Mohanad-Ramadan/sofle-v2-wireless-case/(list of files, drawings)

Other design files:
data/pcb_outline.json
