Mohanad-Ramadan/sofle-v2-wireless-case/(commit log)

2026-04-25 Add Sofle V2 wireless case design spec
    Comprehensive tray-mount case design for Sofle V2 wireless keyboard (nice!nano MCU, MX hot-swap, EC11 encoder, 0.91" OLED). Specifications cover:
    - PCB geometry (143.5 × 115.5 mm irregular outline from GERBER)
    - 5× M2 integrated standoffs (stepped, floor to plate)
    - Tray mounting with open top
    - MCU cover (17 mm tall, merges with +Y wall for USB-C access)
    - Cutouts for slide switch, reset button, USB-C, encoder, OLED
    - Build123d (Python CAD) implementation framework
    - Material & print notes (PLA/PETG, 0.2 mm layer height)
    Design verified against component placements (CPL) and heights (reference STL).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
2026-04-25 constants: dimensions + PCB→case transform with sanity tests
2026-04-25 fix: MOUNTING_HOLES → immutable tuple; type annotations; comment consistency
2026-04-25 data: vendored EdgeCuts gerber, PTH drill, CPL
    [CPL-SofleKeyboard.csv, SofleKeyboard-EdgeCuts.gbr, SofleKeyboard-PTH.drl]
2026-04-25 parse: GERBER edgecuts + Excellon drill → JSON cache
    [pcb_outline.json]
2026-04-25 fix: remove collinear polygon vertices; arc guard; cleanup
    - Add _remove_collinear() helper to strip collinear mid-points from
    polygon output (22 → 19 vertices); prevents OCCT failures on offset()
    - Add arc-segment guard raising ValueError if G02/G03 codes detected
    - Rename header → text in parse_pth_holes for clarity
    - Remove unused import sys
    - Fix hardcoded 4.1 echo string to use target_dia_mm variable
    [pcb_outline.json]
2026-04-25 parse: CPL CSV → components.json
2026-04-26 geometry: load PCB polygon + translate to case coords
2026-04-26 test: cached holes match constants
2026-04-26 standoff: stepped standoff with M2 self-tap bore
2026-04-26 tray: outer shell + PCB-shaped cavity + top chamfer
2026-04-26 fix: cavity overshoot epsilon 1.0→0.01; drop no-op Plane.XY.offset(0)
2026-04-26 cutouts: USB-C, slide-switch slot, reset pin, floor recess
2026-04-26 case: compose tray+standoffs+cover-cutouts; mirror for right half
2026-04-26 cli: build.py exports STL + STEP per side
2026-04-26 test: print envelope fits 250x210 bed
2026-04-27 feat: integrate OCP CAD Viewer with show() support and Pylance fixes
    - Add OCP CAD Viewer show() blocks to all geometry modules (case, tray, cutouts, mcu_cover, standoffs)
    - Add --show flag to build.py for optional viewer launch
    - Guard show() calls with __main__ checks to prevent circular import
    - Use absolute imports for VS Code REPL compatibility
    - Resolve all Pylance/pyright type errors across geometry modules
    - Add AGENT.md with development instructions
2026-05-01 feat: reshaped cutouts for better design experince + built phantom pcb model
2026-05-01 feat: switch plate + MX switch phantoms, Z-stack doc, plate thickness fix
    Switch plate phantom (plate_phantom.py):
    - Parse top_plate.kicad_pcb Edge.Cuts → plate_outline.json + plate_cutouts.json
    (30 cutouts: 29 MX 14×14mm + 1 encoder hole)
    - Plate phantom extruded PLATE_SEAT_Z→PLATE_TOP_Z with cutouts and mounting holes
    MX switch phantom (switch_phantom.py):
    - 29 MX switches: lower housing (13.8×13.8×3mm in gap) + upper housing
    (15.6×15.6×6.6mm above plate) + stem (Ø4.5×3.5mm)
    - Positions + rotations from data/components.json (top-layer SW*, excludes encoder SW25)
    - Gated by SHOW_SWITCH_PHANTOM (default False)
    Z-stack geometry corrections:
    - PLATE_SEAT_Z = 9.1 (PCB_TOP_Z + 3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
2026-05-03 feat: raise case rim to mid-upper-housing height + PNG export flag
    - Add --png flag to build.py for OCP viewer screenshot export
    - Raise MAIN_RIM_Z from 12.0 → 14.0 mm (midpoint of MX upper housing
    10.7 → 17.3 mm); USB_C_Z_RANGE and SLIDE_SWITCH_Z_RANGE auto-adjust
    - Update z-stack.md and AGENT.md to reflect new rim height
2026-05-22 feat(case): full case revamp — PCB-profile shell, MCU hill, smooth tray curves (#1)
    * feat: PCB-profile outer shell + minimalist 2.5mm walls
    Replace rectangular outer shell with PCB polygon offset outward by
    (WALL_THICKNESS + PCB_XY_CLEARANCE = 3.0mm) using Kind.ARC corners.
    Case silhouette now follows the PCB outline exactly — thumb cluster
    diagonal, OLED/encoder step notches, right-side step-down.
    - WALL_THICKNESS: 3.0 → 2.5mm; OUTER_WIDTH/DEPTH: 162×131 → 149.5×121.5mm
    - tray._outer_shell(): polygon offset replaces RectangleRounded
    - tray._fillet_top_edges(): fillet replaces chamfer (polygon ARC corner
    segments break OCC chamfer; fillet handles them robustly)
    - constants: ad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
2026-05-31 feat(case): implement mirroring for right case half (#2)
    * feat(case): implement mirroring for right case half geometry
    Enhance the `build_case_half` function to support mirroring of the case geometry when the `side` parameter is set to "right". This allows for the correct alignment of the MCU hill on the +X wall. Additionally, a new helper function `_mirror_part` is introduced to apply the same transformation to phantom parts, ensuring consistent alignment with the case geometry. Update the main execution block to utilize this new functionality for PCB and other phantoms.
    * fix(case): correct mirroring logic for case halves
    Update the `build_case_half` function to ensure that the "left"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
2026-07-03 chore(docs): fdm-printability-fixes into main
2026-07-05 feat(battery): support 405070 LiPo cell with MCU cover clearance
    Adds a 50x70x4mm battery pocket sized for larger-capacity 405070 cells
    and relieves the MCU cover +Y wall so the B+/B- pins clear the case.
2026-08-11 feat(case): sandwich clamshell — TOP tub + rabbet BOTTOM plate, fused MCU canopy, encoder plateau (#3)
    * fix(tray): eliminate orphan arc kink at −X/+Y corner and fillet new bump edge
    The +Y relief bump started at Y=115.5, leaving the polygon's Kind.ARC
    arc exposed between Y=113.5–115.5 — the wall dipped inward 0.76 mm
    before snapping back. Extend the bump down to the arc start (Y=113.5)
    so the −X wall face is continuous, and fillet the resulting sharp 90°
    corner at (8.5, 119.0) with r=3.0 to match polygon offset arc style.
    * fix(tray): shrink inner wall step at MCU relief corner to sub-nozzle width
    The +Y relief widen cut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
2026-08-16 fix: assembly-blocking defects across seam, encoder, JST, and MCU bay (#4)
    * fix(cover): give switch windows a real assembly clearance
    COVER_WINDOW_OFFSET was 0.85, making a 15.70 mm window over a 15.60 mm MX
    collar: 0.05 mm per side, on all 29 switches, engaging simultaneously in the
    last millimetre of travel. The printed case would not close over the keyboard
    while the empty shells mated perfectly.
    Measured on the built TOP: at 0.85 every one of the 29 windows binds on a
    collar oversized by only 0.10 mm. The tolerance stack against it is at least
    ±0.3 mm common-mode plus ±0.1 mm per switch — the tub floats ±0.2 on M2 in
    Ø2.4 cover holes, the plate floats ±0.1 on Ø3.9 pins in its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
2026-08-19 feat(snaps): eleven invisible rabbet snap latches around the seam (#5)
    * fix(cover): name the keycap-skirt clearance and kill a broken comment
    test_keycap_headroom checked cover_top against a bare 1.5 literal
    labeled 'measured' with no actual measurement behind it. Cherry's MX
    datasheet has no keycap-skirt spec (keycaps are third-party), so this
    was never verifiable against switch data. Named it
    KEYCAP_SKIRT_CLEAR_AT_FULL_PRESS and documented its real provenance:
    a geekhack field report (~2mm nominal, contact at ~1.5mm on hard
    edge-press) adopted as the working number since sub-0.1mm measurement
    tooling wasn't available to verify it directly against this keycap set.
    Also removed the commen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
2026-08-19 feat(encoder): square plinth bezel with circular top, on corrected hardware (#6)
    * feat(encoder): square plinth bezel with a circular top, on corrected hardware
    The cover-side encoder redesign, reconciled against the encoder as it is now
    rather than as the brainstorm assumed it.
    Ships "plinth": a rounded-square skin hugging the square cavity, morphing to a
    Ø12.5 circular top that tucks under the knob. 15.12 flats against the sealed
    ring's Ø19.5 — 2.19 mm less per side where the case is actually seen, and a
    third less material — because a circle has to span the SQUARE cavity's corners
    and so wastes ~3 mm/side across its flats. The small top is bought by stepping
    the cavity in above th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
2026-08-20 feat(canopy): restyle puzzle marks as clothoid-ish curves (#7)
    * test(encoder): record why the square cavity needs no dog-bone relief
    FDM cannot print a sharp internal corner, so the printed cavity always carries
    material the model does not, and the usual answer is a corner relief. This
    cavity does not need one: squaring it left 0.754 mm at the corners, while a
    0.4 mm printed fillet intrudes 0.166 mm along the diagonal.
    A relief would also not be free. The skin's corner arc is centred on the
    cavity's corner point (skin R equals the wall), so the wall there is a uniform
    annulus and a dog-bone eats it 1:1 — r0.3 takes it to 0.5, under the minimum,
    unless the flats grow by the same amount a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
2026-08-25 fix: snap-fit reliability, foot seats, and closing force (#8)
    * fix(feet): restore Ø10 rubber-foot seats by moving the feet, not shrinking them
    Reported from a print: the foot seats came out smaller than the Ø10 pads
    already on hand. Correct — FOOT_DIA was cut 10.0 -> 8.0 in 8790f2b (snaps),
    on the reasoning that "the rubber-foot seats, not the seam, decide where the
    arms can go, and at Ø10 four of nine relief slots foul a seat", with moving a
    foot ruled out because it had been tried on wip/snap-latches and had not
    survived.
    THE DECISION WAS SOUND AND ITS JUSTIFICATION EXPIRED INSIDE THE SAME PR. Two
    later passes moved every slot the Ø10 survey had been measured against: the
    arms wen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
2026-08-28 feat: screwless snap-case redesign (#9)
    * feat(snaps): re-tune latches to hold the seam alone (screwless-ready)
    Make the perimeter snap latches sufficient as the sole closure, without the
    5 standoff M2 screws. Two independent things keep the case shut, and they are
    tuned separately:
    - PULL-OFF (case pulled straight apart, e.g. a drop's separation) is the 90 deg
    self-locking undercut's job — fracture-limited, ~14x the desk-drop shock load,
    and independent of closing force. Unchanged.
    - PRY/SPREAD (a drop or bag load that spreads the seam and flexes the arms) is
    resisted by ARM STIFFNESS (~ thickness^3). The arms are run THICK for this:
    2.20 mm on the long arms and the N2 corner, 2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
2026-09-14 feat(case): flatten base and harden screw-less closure (#10)
    * feat: remove typing angle, flat bottom at Z=0
    Replace the 6° integrated tent wedge with a flat underside at Z=0; the two
    clamshell halves now part along a single flat Z=0 line. The internal Z-ladder
    is unchanged except for the JST-floor fix below.
    The tent angle and wedge height are denominators and guard anchors throughout
    the seam/wave derivation, so they cannot be zeroed in place (÷tan(0) in
    SEAM_TAIL_SLOPE, ÷TENT_WEDGE_MAX_H=0 in _seam_wave_band crash constants.py at
    import). Instead the wave/wedge/skirt/blind-port-skin machinery is deleted and
    tent_plane/tent_ground_z/wedge_deep_z survive as flat Z=0 shims (snaps.py cal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
2026-09-15 refactor(case): replace clamshell with monolithic STL tray
2026-09-15 docs: document STL-only monolithic workflow
2026-09-15 fix(case): remove slide switch actuator ceiling
2026-09-15 fix(tray): strict PCB-frame wall for tall-header MCU
2026-09-16 fix(case): straight PCB+0.2 bore, keep notch
2026-09-16 fix(case): close MCU bay solid to bore wall
2026-09-17 test(manifold): filter degenerate cone-apex sliver from boat-bottom facet
2026-09-17 feat(case): boat-bottom float illusion and auto-show phantoms in viewer
2026-09-23 feat(case): add fitted MCU and encoder cover
2026-09-24 fix(case): fit MCU canopy to tray rim and encoder
2026-10-01 fix(case): add continuous concave slide-switch access
    Replace stepped cutouts with a moderate jack-like relief shared by the tray and MCU cover. Preserve the roof and unchanged full-travel phantom; verify localized pad contact and continuous profiles.
    Verification: Ruff passed; 139 tests passed. Both CLI exports and native section/STL topology smoke checks completed.
2026-10-02 fix(case): increase PCB clearance to 0.4 mm
2026-10-02 feat(case): add encoder-centered south scallop
2026-10-02 feat(case): add faceted south recess
2026-10-02 fix(case): blend south bevel into ramp chamfers
2026-10-03 feat(case): resize battery tray and retain wires
2026-10-03 feat(build): default STL export to finest mesh (1e-4 mm, 0.01 rad)
2026-10-08 feat(cover): engrave M17-3 connection mark across the MCU covers
    The two removable covers now carry one shared mark: three narrows lines and
    the steep Bow A curve, drawn once in the assembled pair frame so each cover
    cuts its own piece of the same figure. Grooves are 0.8 mm wide and 0.3 mm
    deep (1.2 mm of roof remains) and, like the old canopy marks, run out
    through the edges, dying away down the chamfers. Only the encoder shaft
    margin and the USB opening are kept clear.
    - cover_mark.py: pure plan geometry (narrows lines, the archived bow,
    centripetal Catmull-Rom for edited curves, assembled<->canonical frames).
    - The narrows fan now eases in (C1) instead of switching on at the pinch,
    r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
2026-10-15 fix(cover): give left MCU cover header-tail headroom and deepen engraving
    The flipped left MCU hangs its jack under the board, so the cover ridge
    fell back to the board top plus 0.6 mm and the soldered header tails
    blocked seating. Add MCU_HEADER_TAIL_H (2.16 mm, the room the right cover
    already has) to cover_ridge_top_z so both ridges match.
    Deepen the M17-3 groove from 0.30 to 0.60 mm (roof keeps 0.90 mm) so it
    prints reliably.
2026-10-16 fix(case): enlarge foot pockets to 11 mm x 1 mm for print tolerance
2026-10-20 feat(oled): add OLED_MODE none|long|short window to the MCU cover
    - Tri-state OLED_MODE (constants) and `build.py --oled`; non-none modes
    write *_oled-{mode}.stl for case and cover and print a fit report.
    - 4-pin 0.91" OLED (39 x 12 module, 1.2 mm pin inset, 6 x 22.38 window)
    placed from the J3 drill pads: right uses pads 0-3, left 1-4, so the
    left window is not a mirror of the right.
    - Ridge clears the module top (+0.6): 27.40 long / 24.20 short; short
    legs also drop the MCU, header tails and USB-C jack by 3.2 mm, with a
    short-left tray USB notch.
    - Cover and tray north wall grow 2.665 mm (flush) to fit the module.
    - `none` stays identical to the previous build; the M17-3 mark kee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
2026-10-20 docs: document build.py options and the case viewer arguments
